chelseathroop/UUVCapstone/Photos/Clyde_130919_11.jpg

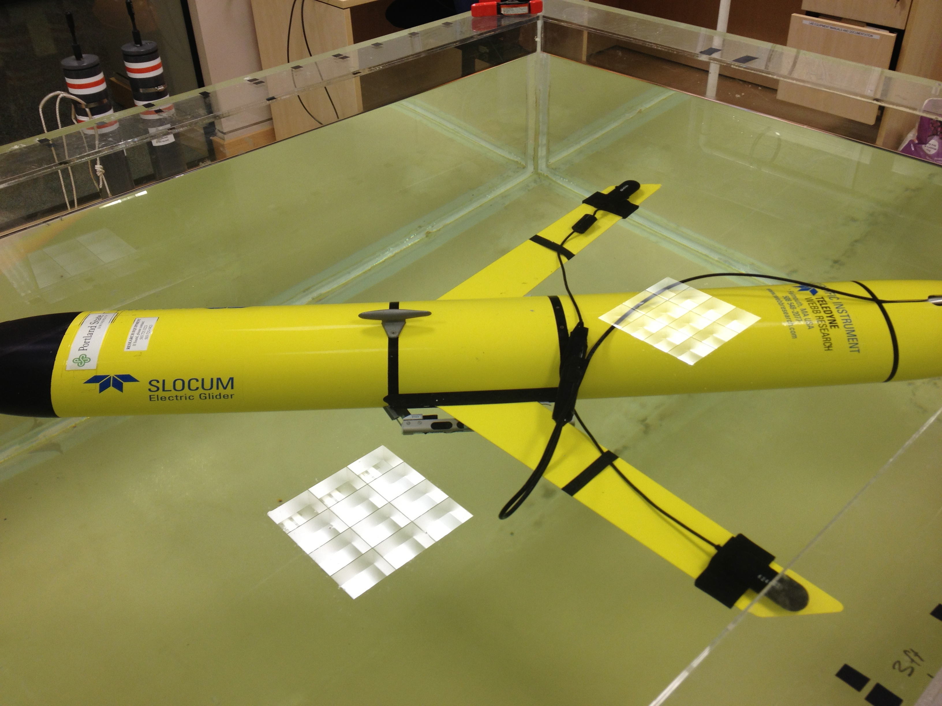
Photos/Clyde_130919_11.jpg
