chelseathroop/UUVCapstone/Photos/Tascam_140603-08.jpg

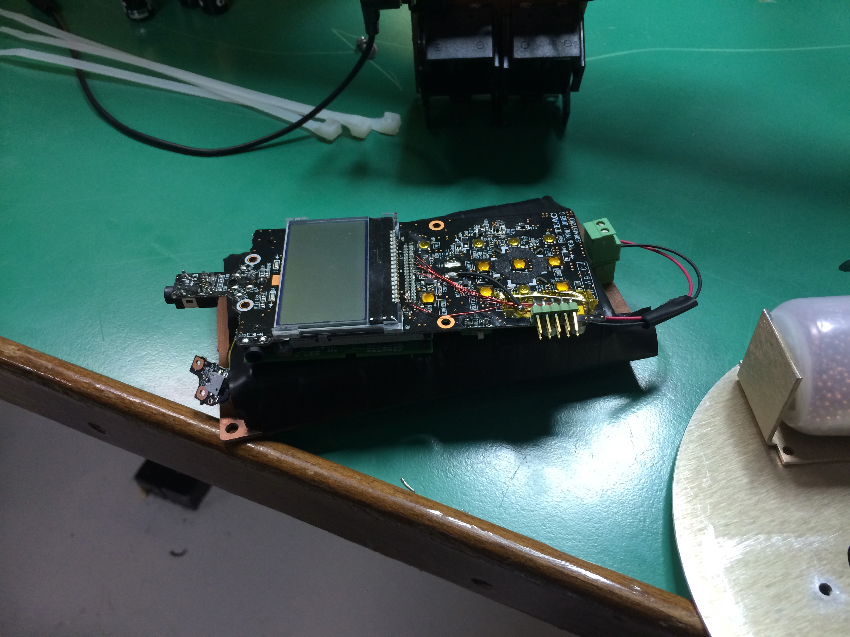
Photos/Tascam_140603-08.jpg
