chelseathroop/UUVCapstone/README.md

# UUVCapstone
Repository for acoustic recording device for UUV Capstone project 2015 at Portland State University.
