chelseathroop/UUVCapstone/RelevantDocuments/TASCAMButtonMapping.docx

TASCAM Button Mapping

Change Sample Rate

1. Menu
2. Fast Forward
3. Minus
4. Fast Forward
5. Down – 44.1k
6. Middle - 48k
7. Up – 96k
8. Menu
9. Menu

Record

1. Record
2. Stop/Home
