chelseathroop/UUVCapstone/SOFTWARE/Software_Highlevel_Algorithm_R1.1.docx

I. Pre- mission

// Get input from user

Do

- (a) : Record_interval = get_data_in () // get_data_in () maybe a pre-defined function or // defined by code writer

Return error message if data input is incorrect, prompt user to have new input

- (b): Sleep_Interval = get_data_in ()

Return error message if data input is incorrect ,, prompt user to have new input

- (c) Sample_Rate = getdatain ()

Return error message if data input is incorrect , prompt user to have new input

- Time_to_start = get_data_in ()

Return error message if data input is incorrect, prompt user to have new input

// Calculation:

Assuming Sample_Resolution =16 bit

// File size for each single record interval

Single_file = Sample_Rate*Sample_solution*Record_Interval

// This step is to make sure the data storage goes smoothly, avoid any corruption in saving data

// process, may not be necessary. Good example :Single_file = 32GB/n where n is integer n>=2.

If Single_file> 128GB // this step can be avoided if the range of input is specified

// in get_data_in () function

Return error message

Go back to (a), (b), (c) Prompt user to have new input for Sample_Rate and Recor_Interval, Sleep_Interval

end

If 128GB >Single_file > 16Gb,

Return message “recommend to change Sample_rate or Record_duration : Yes / No”

If “Yes” go back (a),(b),(c), else continue

else

// Calculate the working time:

On_power_rate = constant1

Sleep_power_rate=constant2

//calculate working time based on power consumption

Power_consumption_until_start = Sleep_power_rate*(Time_to_start – time _now)

Number_of_interval = (Total_power_capacity-Power_consumtion_until_start) /( On_power_rate*Record_Interval + Sleep_Power_rate*Sleep_Interval)

Duration_based_on_power_consumption= (Sleep_interval + Record_Interval)* number_of_interval;

Display on interface.

//calculate working time based on data storage capacity

Duration_based_on_ storage_capacity = (Total_storage_capacity /Single_file) *

(Record_Interval + Sleep_interval)

Display on interface

Working _time =min ( duration_based_on_power_consumption,

Duration_based_on_storage_capacity)

Display on interface

Prompt user to select :

Good_input =1 if satisfied with the schedule

Good_input =0 if unsatisfied with schedule

While good_input= 0;

End do while loop;

// Specify the start time, sleep time and wake-up time:

Time_to_start = Time_to_start

Start=0

Sleep=0

//Open .txt file (or any file suitable for MCU)

FileID= file_open().. //

Fprintf (title, ….)

For i=0 to number_of_interval+1, i=i+1

Start= Time_to_start + i* (Record_Interval+Sleep_Interval)

Sleep=Start+(i+1)*Record_Interval

Fprintf (‘setting…..’ , sample_rate,Record_Interval, Sleep_Interval, Single_file, start, sleep) // save data to file

end

close(fileID)

///////////////////////////////////////////////////////

II In-mission

Initialize RTC

Initialize interrupt

Flag =0;

N=0;

// Get the data from file

Load the file

Sample_rate = read_data_from_file

Record_Interval= read_data_from_file

Sleep_Interval= read_data_from_file

[ start sleep ] = read_data_from_file ( FileID)

Load sample_rate to Tascam

/////// Sleep and wake-up interrupt

For j= 0 to number_of_iterval +1, j=j+1

Wake_up = Program RTC send Interrupt at start (j)

Delay by Record_Interval

_Go_to_sleep = Program RTC send interrupt at sleep (j)

Delay by Sleep_interval

(// Not sure yet how this should work)

End

//Interrupt_ detection function

Checking_ interrupt

While (no interrupt) checking interrupt

If (interrupt)

check if flag=0, start system

N=N+1

Loop :

Call check_free_storage_space (N, free_space) function

If free_space =1 Send sigal to Tascam to save data

Else,

call Mux_switch function

N=0;

End Loop

change flag=1

If flag = 1, go to sleep

Change flag=0

end

//// Check_free_storage_space function (n, free_space)

If n < round_down (32GB/Single_file)-1, free_space =yes

Else, free_space=0;

/// Mux_switch function

If N=round_down(32GB/Single_file) ,

send the signal (binary combination) to switch Mux

send signal to power down Tascam

Delay (some_amount_of_time) // this is for avoiding the interference between

// interrupt and switch procedure

If flag=1

Send the signal to power on Tascam

End
