chelseathroop/UUVCapstone/IssuesandRelevantComments/SDSocketConnectorConcerns.docx

SD Socket Connector Concerns

- Main issue is that the pins of the socket are located underneath the socket making it impossible to solder directly to in the current state.
- Unable to determine which side of pull-up resistors for data lines are connected to power and which side are connected to socket outputs. This is partly due to the inability to probe one side of the resistors while the device is on because they are on the inside of the PCB connected to the main board. Originally wanted to solder mod wires to 402 resistors to break out data lines for connectors.
- Second possibility was to solder to other resistors connected to the data lines that are input to an IC. The problem here is the resistors are not labeled on the PCB and I am unable to determine which resistors I would need to solder to. I also am unable to probe these resistors while the device is on. It may be possible to use ohmmeter to determine, but there are many resistors.
- Lastly, I had concerns about the device always wanting to write to the main SD socket already located on the PCB if an SD card is in the socket, or not wanting to write if one is not available. My thought is to remove the socket and solder wires directly to the available pads for the connector. The only issue with this is that the socket was fairly difficult to remove, as I practiced on a previously damaged board. It was possible, but resulted in the socket coming off in multiple pieces.
