chelseathroop/UUVCapstone/SOFTWARE/Software_Diagram_R_1.pdf

# Software execution block diagram

# Pre-mission module

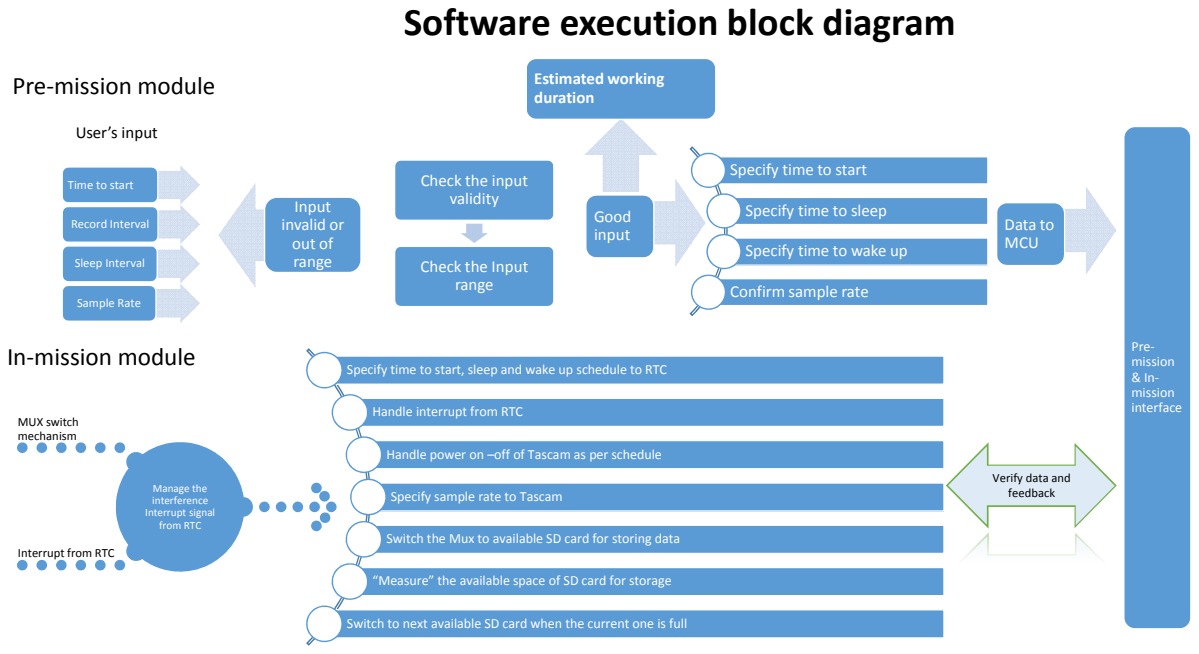
[picture p3: page 1]
Record Interval; Sleep Interval; Sample Rate; Input invalid or out of range; Good input; User’s input; Pre- mission & In- mission interface; Data to MCU; Estimated working duration; Manage the interference Interrupt signal from RTC; MUX switch mechanism

Check the input
validity

Specify time to start

Time to start

Specify time to sleep

Specify time to wake up

Check the Input
range

Confirm sample rate

In-mission module

Specify time to start, sleep and wake up schedule to RTC

Handle interrupt from RTC

Handle power on –off of Tascam as per schedule

Verify data and
feedback

Specify sample rate to Tascam

Switch the Mux to available SD card for storing data

Interrupt from RTC

“Measure” the available space of SD card for storage

Switch to next available SD card when the current one is full
