chelseathroop/UUVCapstone/schematics/board files to make in EPL 5_24_15/Final_board_R1_2.brd

## EAGLE design schematics/board files to make in EPL 5_24_15/Final_board_R1_2.brd (2015-05-25)

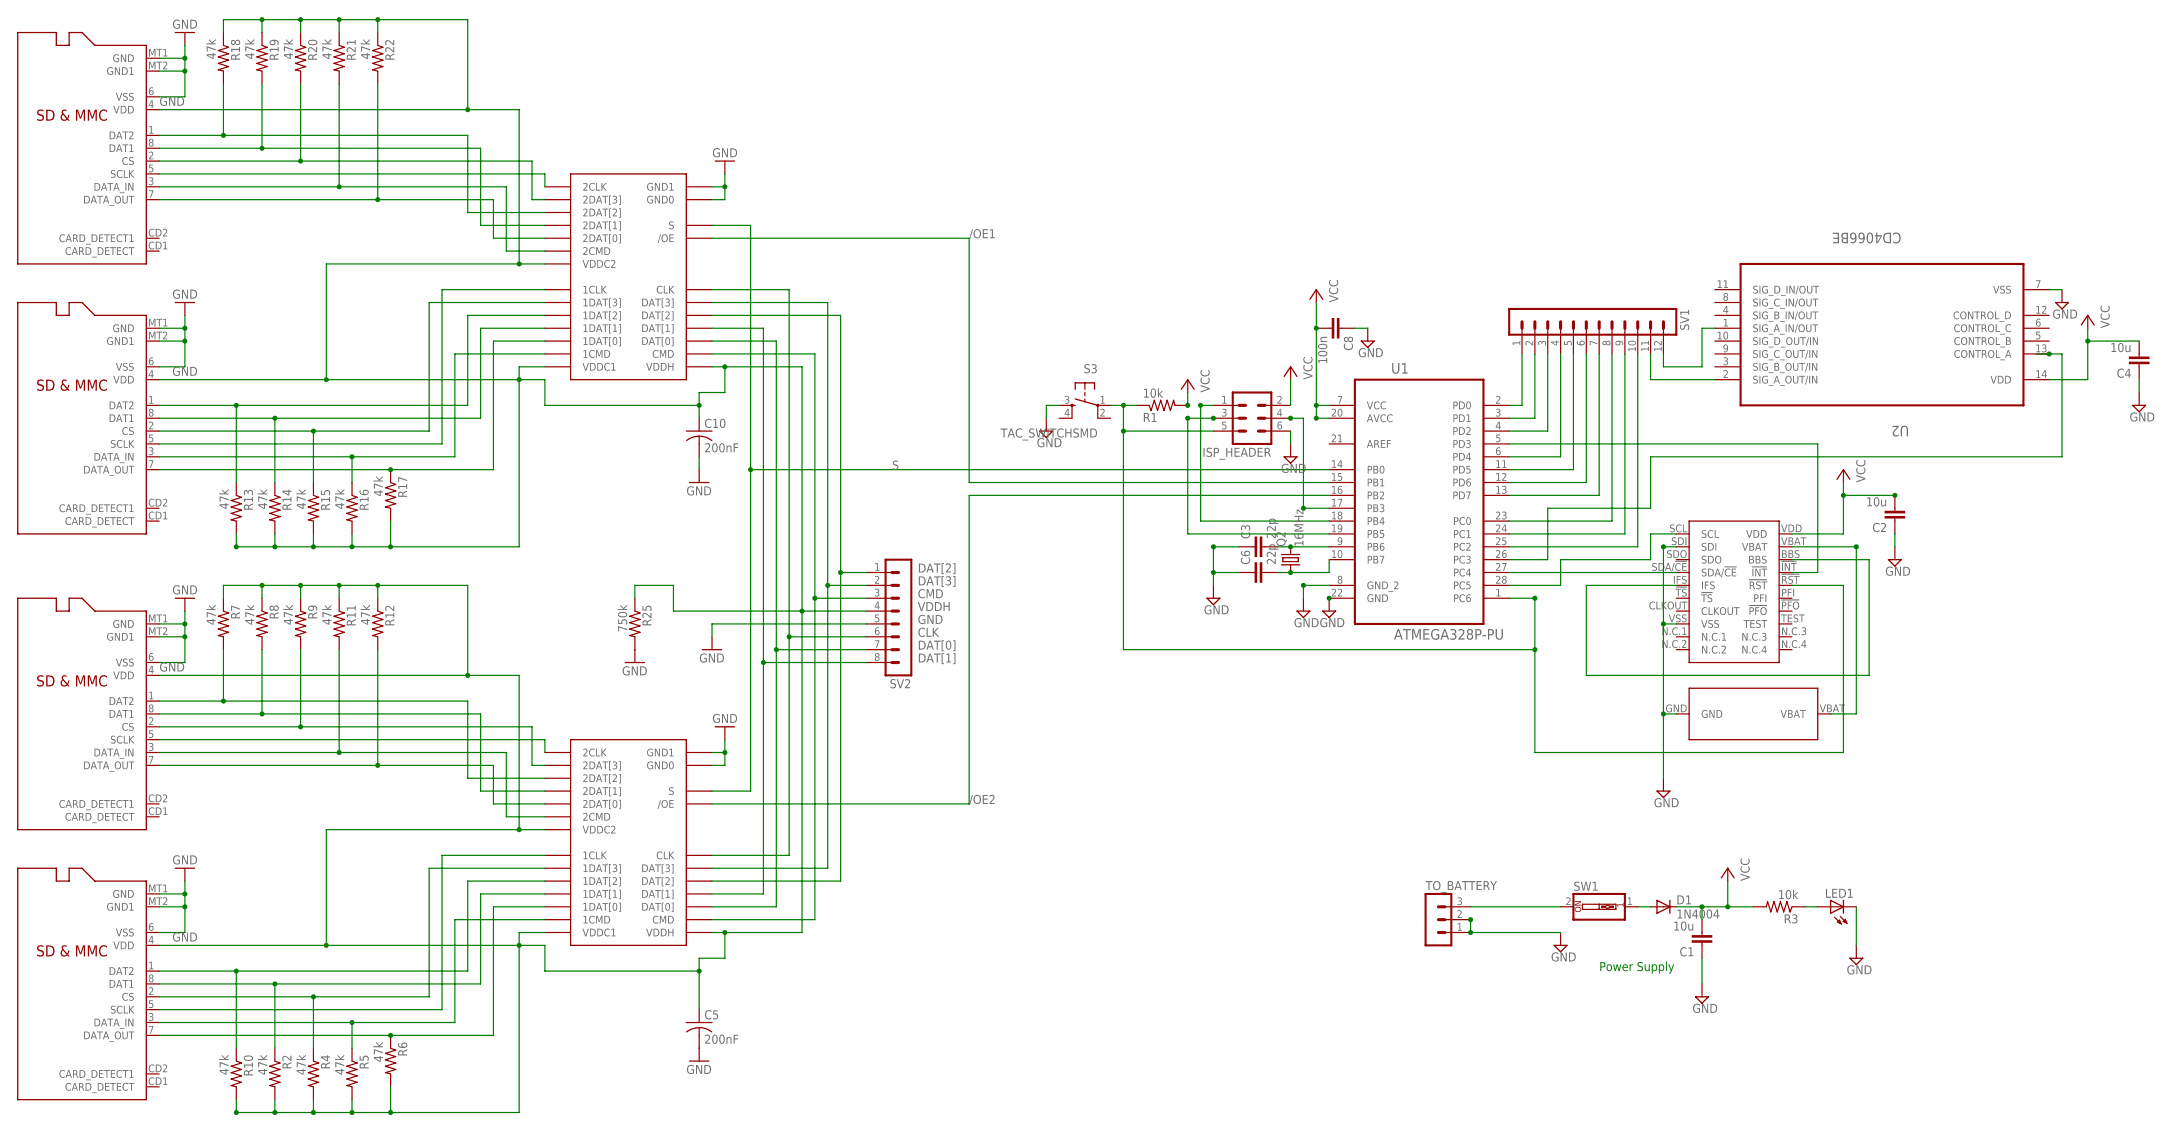
[picture p4: schematic Final_board_R1_2.sch]

Parts:
+3.6V, +3.6V1: FSSD06; MLP-24
C1, C2, C4: 10u; C0805
C3, C6: 22p; C0805
C5, C10: 200nF; C0805
C8: 100n; C0805
D1: 1N4004; DO41-10
ISP_HEADER: MA03-2
LED1: LEDCHIPLED_0805; CHIPLED_0805
Q2: 16MHz; HC49/S
R1, R3: 10k; R0805
R2, R4, R5, R6, R7, R8, R9, R10, R11, R12, R13, R14, R15, R16, R17, R18, R19, R20, R21, R22: 47k; R0805
R25: 750k; R0805
S3: TAC_SWITCHSMD; TACTILE-SWITCH-SMD
SV1: MA12-1W
SV2: MA08-1
SW1: SW_DIP-1; EDG-01
TO_BATTERY: MA03-1
U1: ATMEGA328P-PU; DIP254P762X457-28
U2: CD4066BE; DIP254P762X508-14
U$1: RTC; N5
U$2: CR2032; S8421R
USD1, USD2, USD3, USD4: MICROSD

Connections:
/OE1: +3.6V1./OE, U1.15 (PB1)
/OE2: +3.6V./OE, U1.16 (PB2)
CLK: +3.6V.CLK, +3.6V1.CLK, SV2.6
CMD: +3.6V.CMD, +3.6V1.CMD, SV2.3
DAT[0]: +3.6V.DAT[0], +3.6V1.DAT[0], SV2.7
DAT[1]: +3.6V.DAT[1], +3.6V1.DAT[1], SV2.8
DAT[2]: +3.6V.DAT[2], +3.6V1.DAT[2], SV2.1
DAT[3]: +3.6V.DAT[3], +3.6V1.DAT[3], SV2.2
GND: +3.6V.GND0, +3.6V.GND1, +3.6V1.GND0, +3.6V1.GND1, C1.1, C2.1, C3.1, C4.1, C5.2, C6.1, C8.1, C10.2, ISP_HEADER.6, LED1.C, R25.2, S3.3, SV2.5, TO_BATTERY.1, TO_BATTERY.2, U1.8 (GND_2), U1.22 (GND), U2.7 (VSS), U$1.SDI, U$1.VSS, U$2.GND, USD1.6 (VSS), USD1.MT1 (GND), USD1.MT2 (GND1), USD2.6 (VSS), USD2.MT1 (GND), USD2.MT2 (GND1), USD3.6 (VSS), USD3.MT1 (GND), USD3.MT2 (GND1), USD4.6 (VSS), USD4.MT1 (GND), USD4.MT2 (GND1)
unnamed: +3.6V.1DAT[0], R6.1, USD1.7 (DATA_OUT)
unnamed: LED1.A, R3.1
unnamed: D1.A, SW1.1
unnamed: U1.27 (PC4), U$1.SDA/!CE
unnamed: ISP_HEADER.5, R1.1, S3.1, U1.1 (PC6), U$1.!RST
unnamed: SV1.1, U1.2 (PD0)
unnamed: SV1.2, U1.3 (PD1)
unnamed: C3.2, Q2.2, U1.9 (PB6)
unnamed: C6.2, Q2.1, U1.10 (PB7)
unnamed: ISP_HEADER.3, U1.19 (PB5)
unnamed: SV1.3, U1.4 (PD2)
unnamed: SV1.4, U1.6 (PD4)
unnamed: U1.28 (PC5), U$1.SCL
unnamed: U$1.VBAT, U$2.VBAT
unnamed: SV1.5, U1.11 (PD5)
unnamed: SV1.6, U1.12 (PD6)
unnamed: SV1.7, U1.13 (PD7)
unnamed: SV1.8, U1.23 (PC0)
unnamed: SW1.2, TO_BATTERY.3
unnamed: U$1.BBS, U$1.IFS
unnamed: SV1.9, U1.24 (PC1)
unnamed: SV1.10, U1.25 (PC2)
unnamed: U1.26 (PC3), U2.13 (CONTROL_A)
unnamed: U1.5 (PD3), U$1.!INT
unnamed: SV1.11, U2.2 (SIG_A_OUT/IN)
unnamed: SV1.12, U2.1 (SIG_A_IN/OUT)
unnamed: +3.6V.1DAT[1], R2.1, USD1.8 (DAT1)
unnamed: +3.6V.1DAT[2], R10.1, USD1.1 (DAT2)
unnamed: +3.6V.1CMD, R5.1, USD1.3 (DATA_IN)
unnamed: +3.6V.1CLK, USD1.5 (SCLK)
unnamed: +3.6V.2DAT[3], R9.2, USD2.2 (CS)
unnamed: +3.6V.2DAT[0], R12.2, USD2.7 (DATA_OUT)
unnamed: +3.6V.2DAT[1], R8.2, USD2.8 (DAT1)
unnamed: +3.6V.2DAT[2], R7.2, USD2.1 (DAT2)
unnamed: +3.6V.2CMD, R11.2, USD2.3 (DATA_IN)
unnamed: +3.6V.2CLCK (2CLK), USD2.5 (SCLK)
unnamed: +3.6V.1DAT[3], R4.1, USD1.2 (CS)
unnamed: +3.6V1.1DAT[0], R17.1, USD3.7 (DATA_OUT)
unnamed: +3.6V1.1DAT[1], R14.1, USD3.8 (DAT1)
unnamed: +3.6V1.1DAT[2], R13.1, USD3.1 (DAT2)
unnamed: +3.6V1.1CMD, R16.1, USD3.3 (DATA_IN)
unnamed: +3.6V1.1CLK, USD3.5 (SCLK)
unnamed: +3.6V1.2DAT[3], R20.2, USD4.2 (CS)
unnamed: +3.6V1.2DAT[0], R22.2, USD4.7 (DATA_OUT)
unnamed: +3.6V1.2DAT[1], R19.2, USD4.8 (DAT1)
unnamed: +3.6V1.2DAT[2], R18.2, USD4.1 (DAT2)
unnamed: +3.6V1.2CMD, R21.2, USD4.3 (DATA_IN)
unnamed: +3.6V1.2CLCK (2CLK), USD4.5 (SCLK)
unnamed: +3.6V1.1DAT[3], R15.1, USD3.2 (CS)
unnamed: ISP_HEADER.1, U1.18 (PB4)
unnamed: ISP_HEADER.4, U1.17 (PB3)
S: +3.6V.S, +3.6V1.S, U1.14 (PB0)
VCC: C1.2, C2.2, C4.2, C8.2, D1.C, ISP_HEADER.2, R1.2, R3.2, U1.7 (VCC), U1.20 (AVCC), U2.14 (VDD), U$1.VDD
VDDH: +3.6V.VDDC1, +3.6V.VDDC2, +3.6V.VDDH, +3.6V1.VDDC1, +3.6V1.VDDC2, +3.6V1.VDDH, C5.1, C10.1, R2.2, R4.2, R5.2, R6.2, R7.1, R8.1, R9.1, R10.2, R11.1, R12.1, R13.2, R14.2, R15.2, R16.2, R17.2, R18.1, R19.1, R20.1, R21.1, R22.1, R25.1, SV2.4, USD1.4 (VDD), USD2.4 (VDD), USD3.4 (VDD), USD4.4 (VDD)

Notes on the sheet:
Power Supply

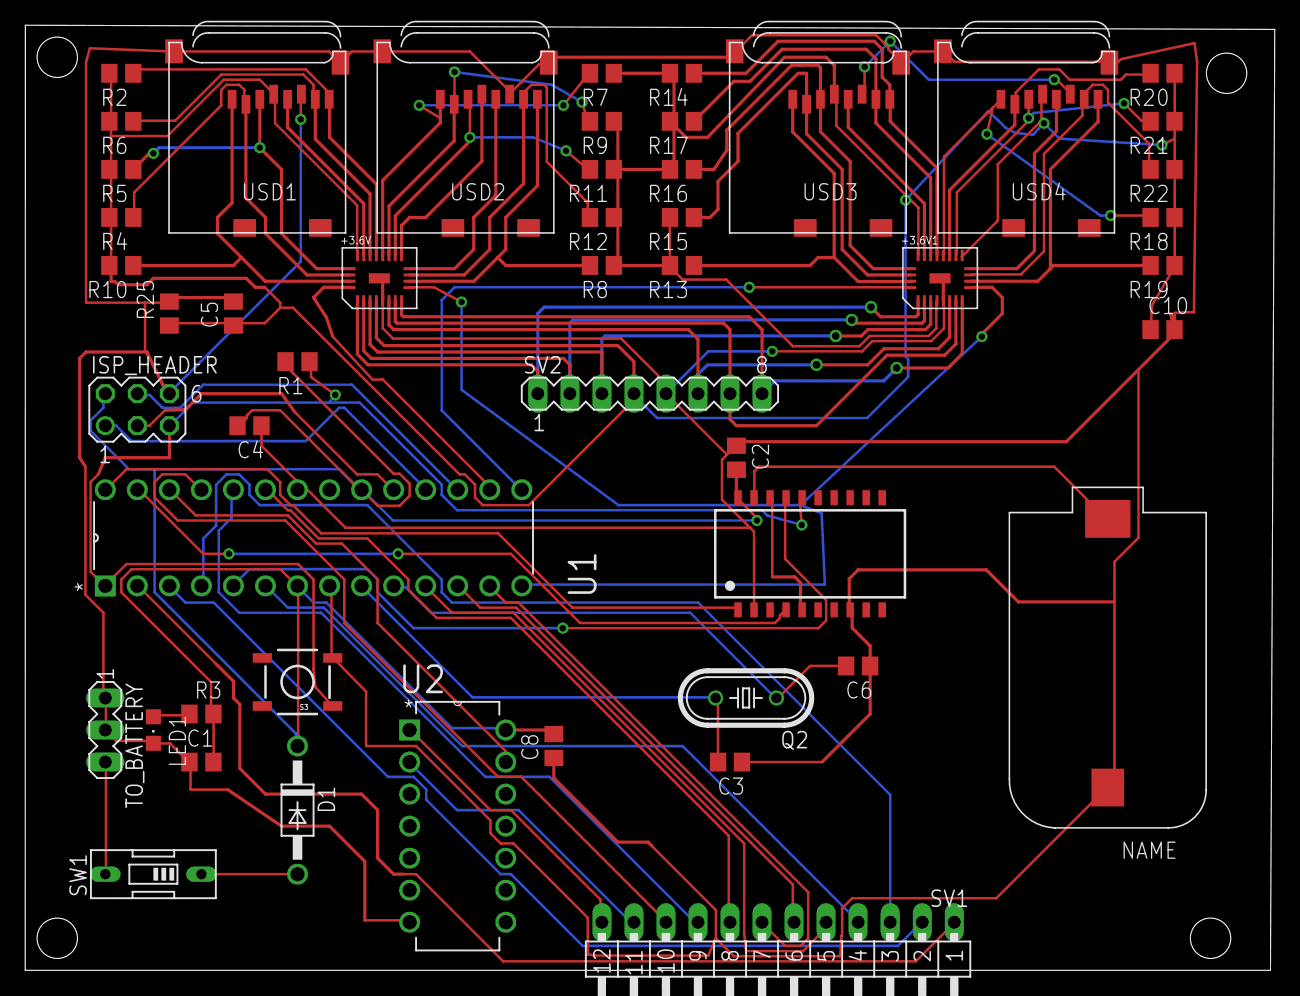
[picture p5: board Final_board_R1_2.brd from above]

Board: 2 copper layers, 99.1 x 74.9 mm, 50 parts (0 on the bottom side), 63 nets.
