chelseathroop/UUVCapstone/schematics/uSD_mux.brd

## EAGLE design schematics/uSD_mux.brd (2015-04-13)

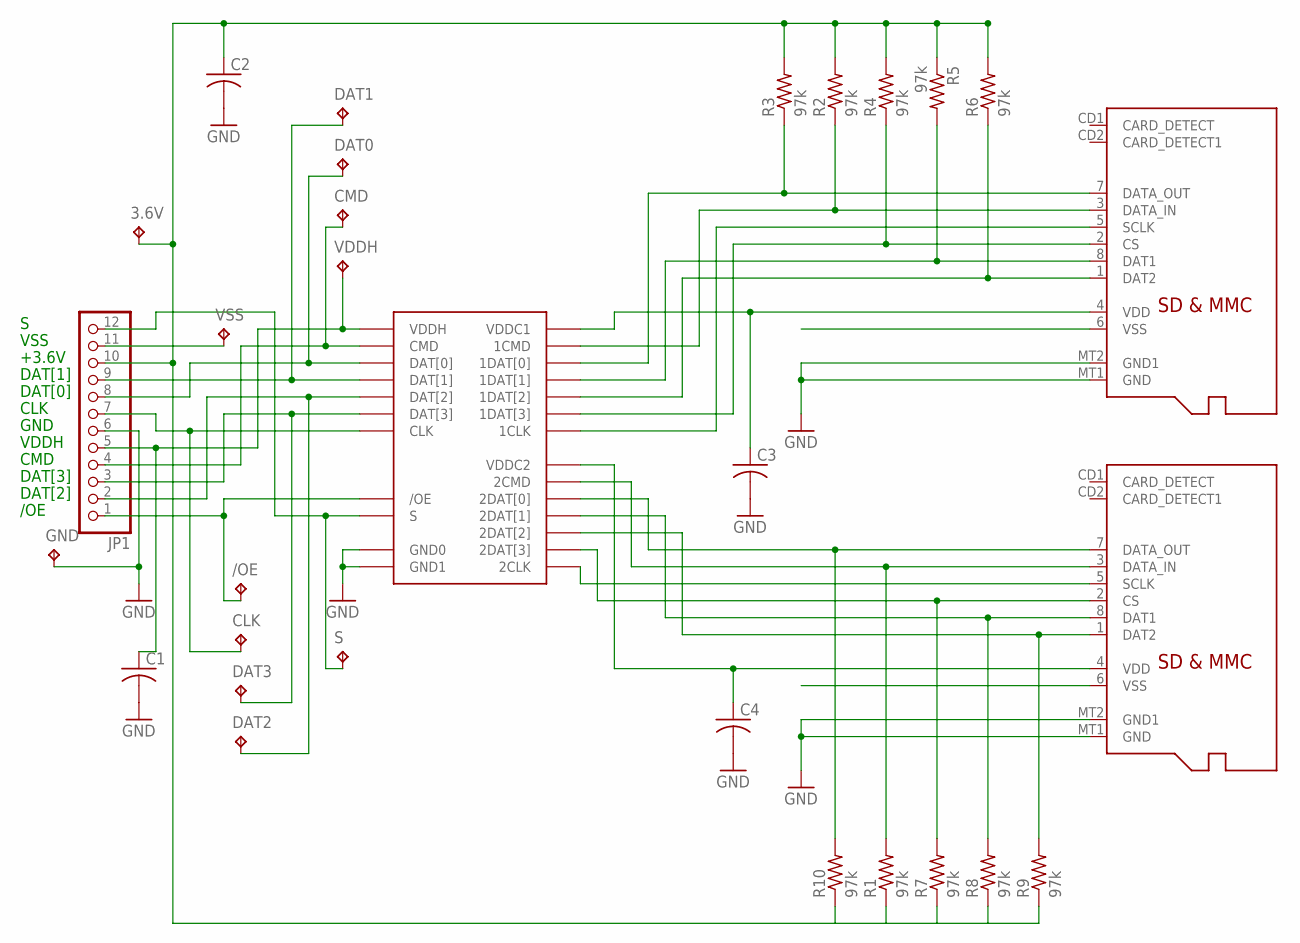
[picture p6: schematic uSD_mux.sch]

Parts:
3.6V: TPTP20R; TP20R
+3.6V: FSSD06; MLP-24
/OE: TPTP20R; TP20R
C1, C2, C3, C4: C-USC0805; C0805
CLK: TPTP20R; TP20R
CMD: TPTP20R; TP20R
DAT0, DAT1, DAT2, DAT3: TPTP20R; TP20R
GND: TPTP20R; TP20R
JP1: PINHD-1X12; 1X12
R1, R2, R3, R4, R5, R6, R7, R8, R9, R10: 97k; R0805
S: TPTP20R; TP20R
USD1, USD2: MICROSD
VDDH: TPTP20R; TP20R
VSS: TPTP20R; TP20R

Connections:
+3.6: 3.6V.TP, C2.1, JP1.10, R1.1, R2.2, R3.2, R4.2, R5.1, R6.2, R7.1, R8.1, R9.1, R10.1
/OE: +3.6V./OE, /OE.TP, JP1.1
CLK: +3.6V.CLK, CLK.TP, JP1.7
CMD: +3.6V.CMD, CMD.TP, JP1.4
DAT0: +3.6V.DAT[0], DAT0.TP, JP1.8
DAT1: +3.6V.DAT[1], DAT1.TP, JP1.9
DAT2: +3.6V.DAT[2], DAT2.TP, JP1.2
DAT3: +3.6V.DAT[3], DAT3.TP, JP1.3
GND: +3.6V.GND0, +3.6V.GND1, C1.2, C2.2, C3.2, C4.2, GND.TP, JP1.6, USD1.MT1 (GND), USD1.MT2 (GND1), USD2.MT1 (GND), USD2.MT2 (GND1)
unnamed: +3.6V.1DAT[3], R4.1, USD1.2 (CS)
unnamed: +3.6V.1DAT[0], R3.1, USD1.7 (DATA_OUT)
unnamed: +3.6V.1DAT[1], R5.2, USD1.8 (DAT1)
unnamed: +3.6V.1DAT[2], R6.1, USD1.1 (DAT2)
unnamed: +3.6V.1CMD, R2.1, USD1.3 (DATA_IN)
unnamed: +3.6V.1CLK, USD1.5 (SCLK)
unnamed: +3.6V.2DAT[3], R7.2, USD2.2 (CS)
unnamed: +3.6V.2DAT[0], R10.2, USD2.7 (DATA_OUT)
unnamed: +3.6V.2DAT[1], R8.2, USD2.8 (DAT1)
unnamed: +3.6V.2DAT[2], R9.2, USD2.1 (DAT2)
unnamed: +3.6V.2CMD, R1.2, USD2.3 (DATA_IN)
unnamed: +3.6V.2CLCK (2CLK), USD2.5 (SCLK)
S: +3.6V.S, JP1.12, S.TP
VDDC1: +3.6V.VDDC1, C3.1, USD1.4 (VDD)
VDDC2: +3.6V.VDDC2, C4.1, USD2.4 (VDD)
VDDH: +3.6V.VDDH, C1.1, JP1.5, VDDH.TP
VSS: JP1.11, USD1.6 (VSS), USD2.6 (VSS), VSS.TP

Notes on the sheet:
VDDH
CMD
DAT[0]
DAT[3]
DAT[2]
/OE
GND
CLK
DAT[1]
VSS
+3.6V

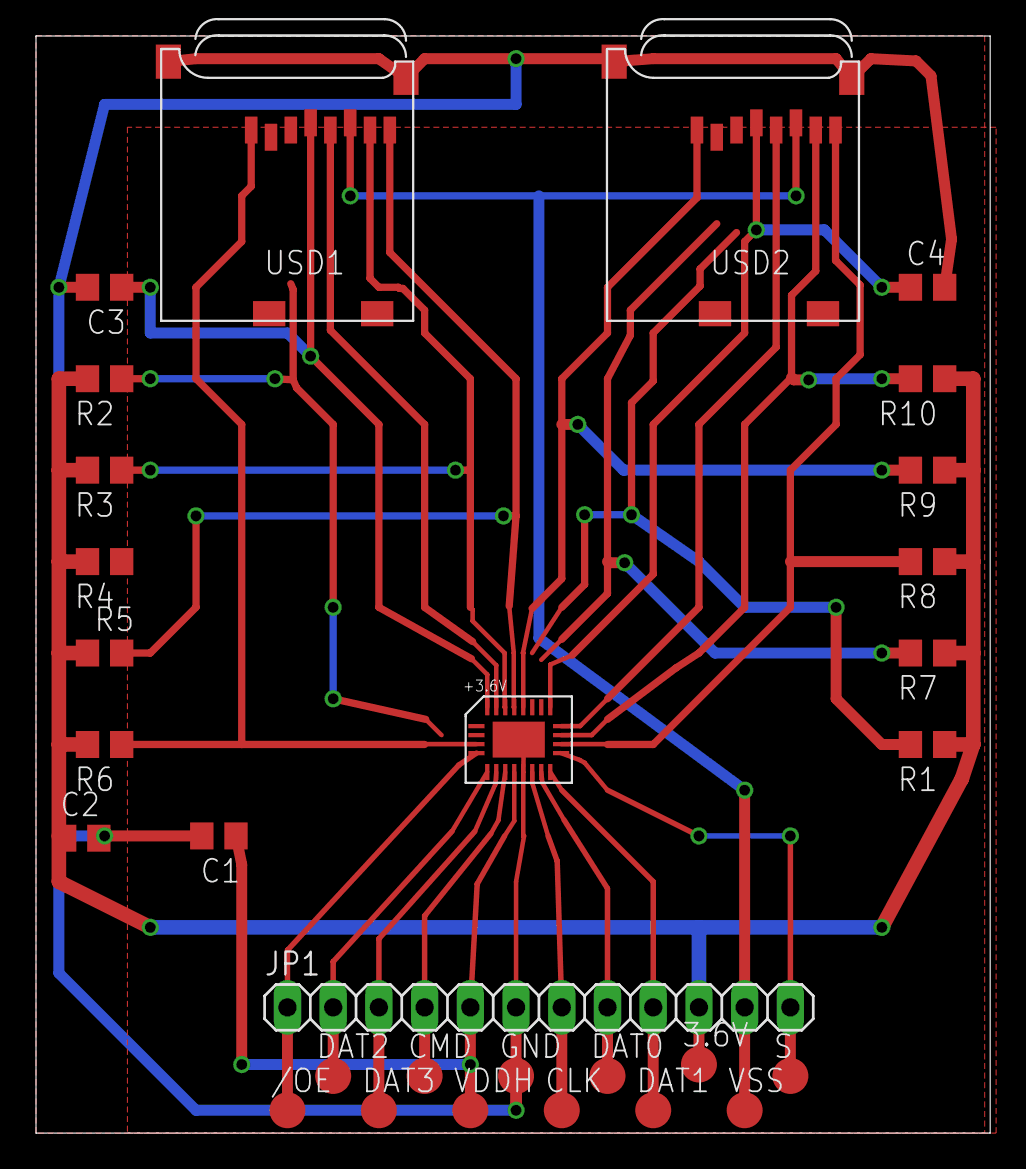
[picture p7: board uSD_mux.brd from above]

Board: 2 copper layers, 53.0 x 61.0 mm, 30 parts (0 on the bottom side), 26 nets.
