chelseathroop/UUVCapstone/schematics/tqfp_0_8mm_breakout.brd

## EAGLE design schematics/tqfp_0_8mm_breakout.brd (2015-04-13)

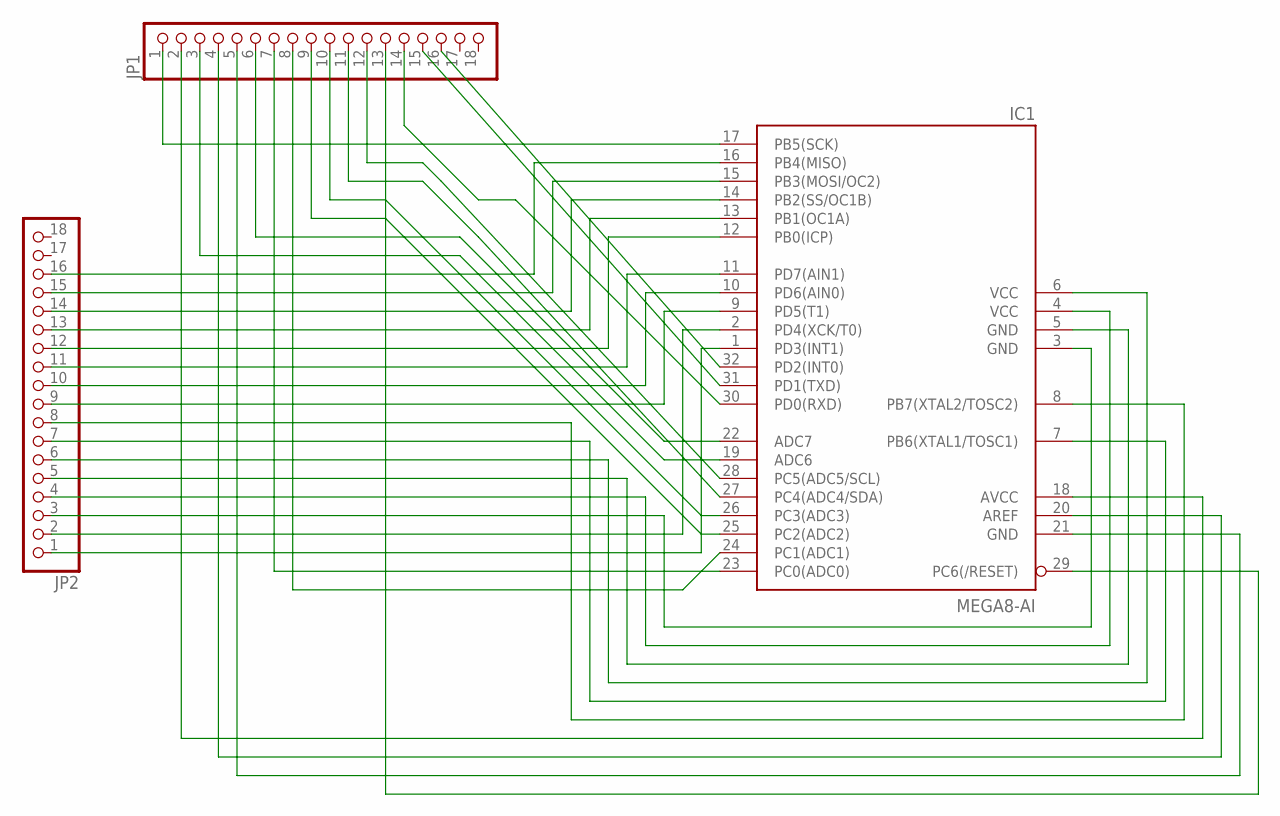
[picture p8: schematic tqfp_0_8mm_breakout.sch]

Parts:
IC1: MEGA8-AI; TQFP32-08
JP1, JP2: PINHD-1X18; 1X18

Connections:
unnamed: IC1.1 (PD3(INT1)), JP2.1
unnamed: IC1.2 (PD4(XCK/T0)), JP2.2
unnamed: IC1.3 (GND), JP2.3
unnamed: IC1.4 (VCC), JP2.4
unnamed: IC1.5 (GND), JP2.5
unnamed: IC1.6 (VCC), JP2.6
unnamed: IC1.7 (PB6(XTAL1/TOSC1)), JP2.7
unnamed: IC1.8 (PB7(XTAL2/TOSC2)), JP2.8
unnamed: IC1.9 (PD5(T1)), JP2.9
unnamed: IC1.10 (PD6(AIN0)), JP2.10
unnamed: IC1.11 (PD7(AIN1)), JP2.11
unnamed: IC1.12 (PB0(ICP)), JP2.12
unnamed: IC1.13 (PB1(OC1A)), JP2.13
unnamed: IC1.14 (PB2(SS/OC1B)), JP2.14
unnamed: IC1.15 (PB3(MOSI/OC2)), JP2.15
unnamed: IC1.16 (PB4(MISO)), JP2.16
unnamed: IC1.17 (PB5(SCK)), JP1.1
unnamed: IC1.18 (AVCC), JP1.2
unnamed: IC1.19 (ADC6), JP1.3
unnamed: IC1.20 (AREF), JP1.4
unnamed: IC1.21 (GND), JP1.5
unnamed: IC1.22 (ADC7), JP1.6
unnamed: IC1.23 (PC0(ADC0)), JP1.7
unnamed: IC1.24 (PC1(ADC1)), JP1.8
unnamed: IC1.25 (PC2(ADC2)), JP1.9
unnamed: IC1.26 (PC3(ADC3)), JP1.10
unnamed: IC1.27 (PC4(ADC4/SDA)), JP1.11
unnamed: IC1.28 (PC5(ADC5/SCL)), JP1.12
unnamed: IC1.29 (PC6(/RESET)), JP1.13
unnamed: IC1.30 (PD0(RXD)), JP1.14
unnamed: IC1.31 (PD1(TXD)), JP1.15
unnamed: IC1.32 (PD2(INT0)), JP1.16

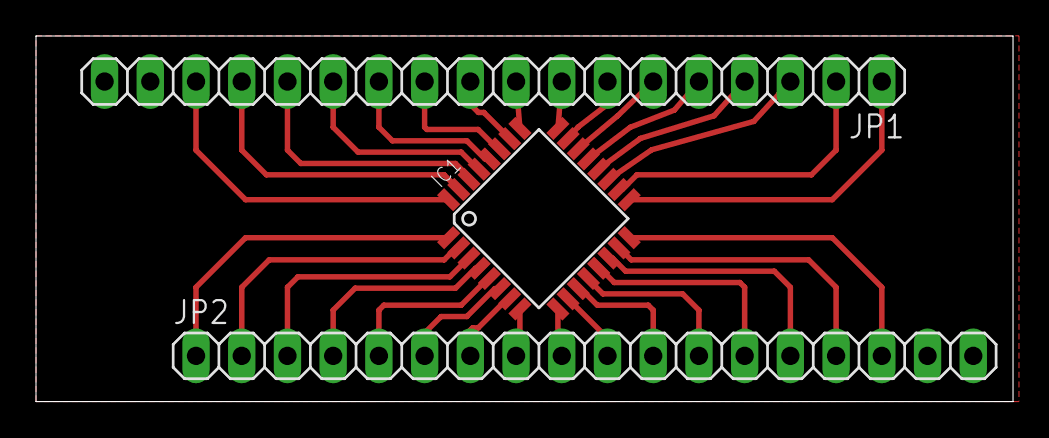
[picture p9: board tqfp_0_8mm_breakout.brd from above]

Board: 2 copper layers, 54.3 x 20.3 mm, 3 parts (0 on the bottom side), 32 nets.
