chelseathroop/UUVCapstone/schematics/uSD_socket_breakout_rev_2.brd

## EAGLE design schematics/uSD_socket_breakout_rev_2.brd (2015-04-13)

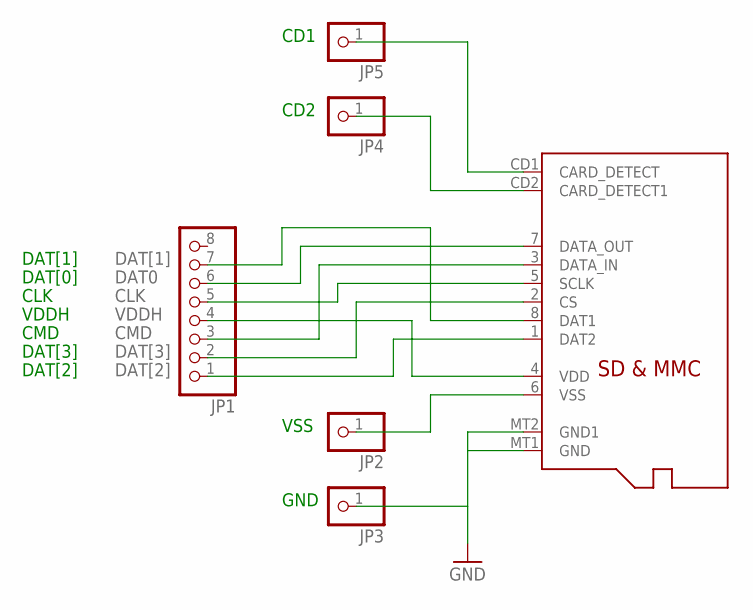
[picture p10: schematic uSD_socket_breakout_rev_2.sch]

Parts:
JP1: PINHD-1X8CLEANBIG; 1X08-CLEANBIG
JP2, JP3, JP4, JP5: PINHD-1X1CB; 1X01-CLEANBIG
U$1: MICROSD

Connections:
CLK: JP1.5, U$1.5 (SCLK)
CMD: JP1.3, U$1.3 (DATA_IN)
DAT0: JP1.6, U$1.7 (DATA_OUT)
DAT[1]: JP1.7, U$1.8 (DAT1)
DAT[2]: JP1.1, U$1.1 (DAT2)
DAT[3]: JP1.2, U$1.2 (CS)
GND: JP3.1, U$1.MT1 (GND), U$1.MT2 (GND1)
unnamed: JP5.1, U$1.CD1 (CARD_DETECT)
unnamed: JP4.1, U$1.CD2 (CARD_DETECT1)
VDDH: JP1.4, U$1.4 (VDD)
VSS: JP2.1, U$1.6 (VSS)

Notes on the sheet:
DAT[1]
DAT[0]
CLK
GND
VDDH
CMD
DAT[2]
CD1
CD2
DAT[3]
VSS

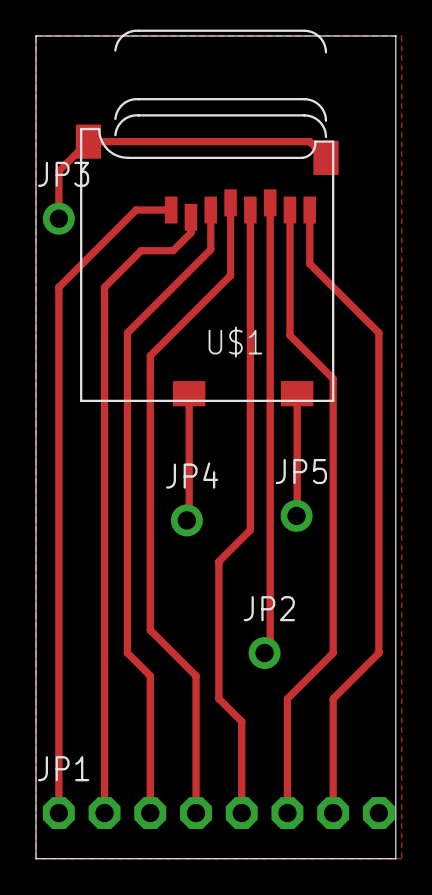
[picture p11: board uSD_socket_breakout_rev_2.brd from above]

Board: 2 copper layers, 20.0 x 45.7 mm, 6 parts (0 on the bottom side), 11 nets.
