chelseathroop/UUVCapstone/schematics/mux_breakout.brd

## EAGLE design schematics/mux_breakout.brd (2015-04-13)

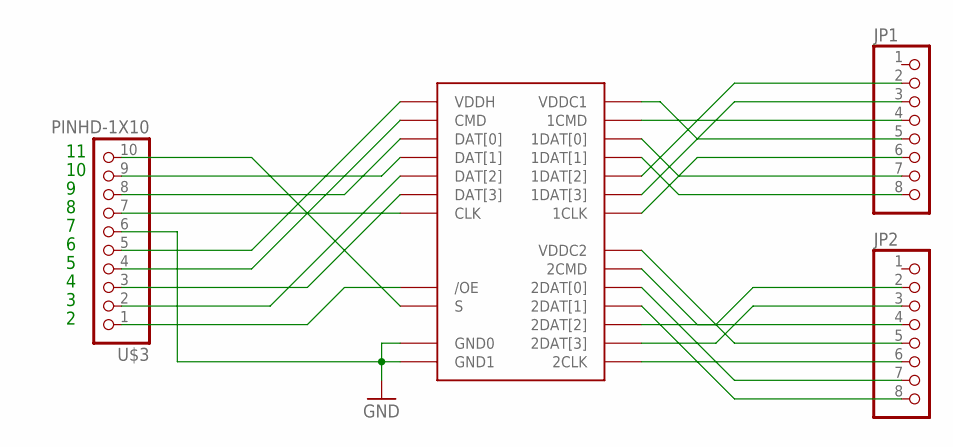
[picture p12: schematic mux_breakout.sch]

Parts:
JP1, JP2: PINHD-1X8CLEANBIG; 1X08-CLEANBIG
U$1: FSSD06; MLP-24
U$3: PINHD-1X10; 1X10-BIG

Connections:
1CLK: JP1.6, U$1.1CLK
1CMD: JP1.4, U$1.1CMD
1DAT[0]: JP1.7, U$1.1DAT[0]
1DAT[1]: JP1.8, U$1.1DAT[1]
1DAT[2]: JP1.2, U$1.1DAT[2]
1DAT[3]: JP1.3, U$1.1DAT[3]
2CLK: JP2.6, U$1.2CLCK (2CLK)
2CMD: JP2.4, U$1.2CMD
2DAT3: JP2.3, U$1.2DAT[3]
2DAT[0]: JP2.7, U$1.2DAT[0]
2DAT[1]: JP2.8, U$1.2DAT[1]
2DAT[2]: JP2.2, U$1.2DAT[2]
/OE: U$1./OE, U$3.1
CLK: U$1.CLK, U$3.7
CMD: U$1.CMD, U$3.4
DAT[0]: U$1.DAT[0], U$3.8
DAT[1]: U$1.DAT[1], U$3.9
DAT[2]: U$1.DAT[2], U$3.2
DAT[3]: U$1.DAT[3], U$3.3
GND: U$1.GND0, U$1.GND1, U$3.6
S: U$1.S, U$3.10
VDDC1: JP1.5, U$1.VDDC1
VDDC2: JP2.5, U$1.VDDC2
VDDH: U$1.VDDH, U$3.5

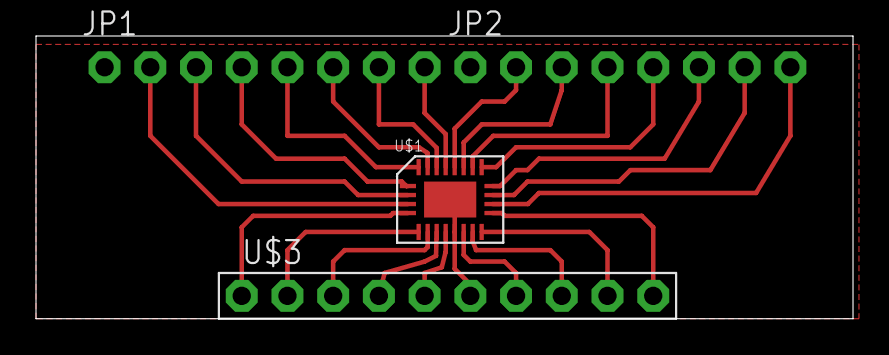
[picture p13: board mux_breakout.brd from above]

Board: 2 copper layers, 45.4 x 15.7 mm, 4 parts (0 on the bottom side), 24 nets.
