chelseathroop/UUVCapstone/SOFTWARE/UUV.h

// TYPEDEFS
typedef uint8_t byte; 
typedef int8_t sbyte;

byte alarm_dhms[][6] ={
	{0x09,0x15,0x41,0x00,44,0},
	{0x09,0x15,0x43,0x00,44,1},
	{0x09,0x15,0x45,0x00,44,0},
	{0x09,0x15,0x47,0x00,48,1},
	{0x09,0x15,0x49,0x00,44,0},
	{0x09,0x15,0x51,0x00,96,1},
	
		{0x09,0x15,0x53,0x00,44,0},
		{0x09,0x15,0x55,0x00,44,1},
		{0x09,0x15,0x57,0x00,44,0},
		{0x09,0x16,0x01,0x00,48,1},
		{0x09,0x16,0x03,0x00,44,0},
		{0x09,0x16,0x05,0x00,96,1},
	


	
	{0x09,0x16,0x53,0x00,44,0},
	{0x09,0x17,0x55,0x00,48,1},
	{0x09,0x18,0x59,0x00,44,0},
	{0x09,0x19,0x01,0x00,44,1},
	{0x09,0x20,0x03,0x00,44,0},
	{0x09,0x21,0x05,0x00,96,1},
	{0x09,0x22,0x09,0x00,44,0},
	{0x09,0x23,0x11,0x00,44,1},
	{0x09,0x23,0x59,0x00,44,0},
	{0x10,0x00,0x17,0x00,96,1},
	{0x10,0x01,0x22,0x00,44,0},
	{0x10,0x02,0x25,0x00,48,1},
	{0x10,0x03,0x28,0x00,44,0},
	{0x10,0x04,0x30,0x00,44,1},
	{0x10,0x06,0x00,0x00,44,0},
	{0x10,0x07,0x05,0x00,44,1},
	{0x10,0x08,0x45,0x00,44,0},
	{0x10,0x09,0x00,0x00,48,1},
	{0x10,0x10,0x41,0x00,44,0},
	{0x10,0x11,0x41,0x00,96,1},
	{0x10,0x12,0x45,0x00,44,0},
	{0x10,0x13,0x05,0x00,44,1},
	{0x10,0x15,0x00,0x00,44,0},
	{0x10,0x17,0x00,0x00,48,1},
	{0x10,0x18,0x30,0x00,44,0},
	{0x10,0x19,0x00,0x00,96,1},
	{0x10,0x20,0x00,0x00,44,0},
	{0x10,0x21,0x15,0x00,44,1},
	{0x10,0x22,0x00,0x00,44,0},
	{0x10,0x23,0x41,0x00,96,1},
	{0x11,0x00,0x45,0x00,44,0},
	{0x11,0x01,0x05,0x00,44,1},
	{0x11,0x02,0x00,0x00,44,0},
	{0x11,0x03,0x00,0x00,48,1},
	{0x11,0x04,0x30,0x00,44,0},
	{0x11,0x05,0x00,0x00,96,1},
	{0x11,0x06,0x00,0x00,44,0},
	{0x11,0x07,0x15,0x00,44,1},
	{0x11,0x08,0x00,0x00,44,0},
	{0x11,0x09,0x30,0x00,44,0},
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
};


int const CD1=10;
int const CD2=13;
int const CD3=10;
int const CD4=15;

	
	
