chelseathroop/UUVCapstone/(commit log)

2015-01-22 Adding meeting minutes from last night and Powerpoint template for proposal
2015-01-22 Updating powerpoint template for everyone to add their sections to
2015-01-23 Uploading photos for powerpoint, relevent document, and meeting minutes
2015-01-24 Updated power point with notes from meeting and added Phu's updates
2015-01-26 Added button interface slide
2015-01-26 SAved current pdf
2015-01-27 Preliminary Power Budget for Daughterboard
    [Preliminary power budget.xlsx]
2015-02-17 mux circuit and relevant datasheets
    Datasheets of components used in MUX circuit. Schematics not yet
    finalized, need some review before sending to oshpark.
    [uSD_mux.brd, uSD_mux.sch]
2015-02-18 Added document addressing concerns about SD socket connector
2015-02-19 Added folder section to comment on current issues and relevant comments.
2015-02-24 Updated uSD mux board
    [uSD_mux.brd, uSD_mux.sch]
2015-02-24 Added button sequence for changing sample rate and recording
2015-02-24 Updated uSD mux board layout
    Forgot to check oshpark DRU before committing first time. Made
    revisions necessary to board layout to meet oshparks design rules.
    [uSD_mux.brd]
2015-02-24 Updated uSD mux sch/brd files
    Added decoupling capacitors, labeled +3.6V connection on 12 pin
    connector.
    [uSD_mux.brd, uSD_mux.sch]
2015-02-25 Updated uSD board layout
    Board was excessively expensive, changed board layout to reduce surface
    area --> cheaper fab . Previous iteration was quoted $37 at oshpark,
    updated board $25.
    [uSD_mux.brd]
2015-02-26 uSD socket breakout board
    [uSD_socket_breakout.brd, uSD_socket_breakout.sch]
2015-03-02 MCU and RTC interface circuit diagram Revision R1.0
    [MCU_RTC_DIAGRAM_REV1.0.sch]
2015-03-27 updated RTC-MCU schematic : implemented CMOS as switches for button services. Uploaded on 03/27/15
    [MCU_RTC_DIAGRAM_REV_2.0.sch]
2015-03-31 Service button code revision 1. Posted 033015
2015-04-03 sample_input_file
    Sample input file
2015-04-05 Added integrated circuit template and BOM
    [MCU_RTC_MUX_INTEGRATED_040215_REV_1.0.sch]
2015-04-09 TQFP-32-08 breakout board
    Drafted breakout board for atmega168a tqfp 0.8mm pitch for Phu
    [tqfp_0_8mm_breakout.brd, tqfp_0_8mm_breakout.sch]
2015-04-09 MLP-24 breakout board
    Breakout board for FSSD06 w/ MLP-24 package.
    [mux_breakout.brd, mux_breakout.sch]
2015-04-11 Breakout boards for MUX and uSD socket, updated mux+uSD schematic
    Built individual breakout boards for MUX chip and uSD socket.
    Discovered errors in MUX and uSD integrated board and updated
    schematic--ripped up wrong connections in .brd file but did not bother
    rerouting traces since this board will most likely not be fabbed again.
    [uSD_mux.brd, uSD_mux.sch, uSD_socket_breakout_rev_2.brd, uSD_socket_breakout_rev_2.sch]
2015-04-17 Added sd slot datasheet for reference
2015-04-20 Updated sample for file generated by pre-mission software
2015-04-29 Added current premission software version
2015-05-13 Adding current version of application with first implementation of error checking
    [PreMissionApplication.py]
2015-05-13 Added error checking for all entries
    [PreMissionApplication.py]
2015-05-14 Updated circuitry for MCU-RTC-BUTTON SERVICE interface
    [MCU_RTC_MUX_INTEGRATED_051215_R1.sch]
2015-05-15 final schematic/board layout
    Schematic is done, working on board layout, this may take a few days for
    me to complete.
    [Final_board_R1.brd, Final_board_R1.sch]
2015-05-24 Prelim Layout Complete
    Completed first board layout in eagle cad. Needs revision.
    [Final_board_R1_1.brd, Final_board_R1_1.sch]
2015-05-24 test sample
2015-05-25 Uploaded new layout for routing
    Had to rework board layout to accommodate current LPKF router
    functionality(2 tooling slots out of order, limited to max 10 instead of
    12 tools for job). I'm including gerber files from CAM processing. The
    top, bottom, outline .gbx files are needed, as well as the .xln drill
    file, to import into the routing program.
    [Final_board_R1_2.brd, Final_board_R1_2.sch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]
